cthill/SNESDump/(threads)

Thread 1 (2019-01-16):

Reading stop and program freeze

jeffersonmsb, 2019-01-16:
On my setup, reading stop and program freeze in 32kb or 64kb.
I believe that because my setup is protoboard and my arduino is chinese (USB to serial is CH340).
I reduce the serial baudrate for 115200 and and everything works.

cthill, 2019-01-16:
Hello! I did not have much success with high baud rates on cheap Arduino clones. Try swapping it for an Arduino board with a legitimate FTDI USB to serial chip. I used the Arduino Nano for my build.

Also, what operating system are you using?

jeffersonmsb, 2019-01-17:
Hi. I no have a legitimate arduino and its more expensive in my country.
But that's not a problem for me. Wanted to leave the warning to other people who have cheapest arduino.

I use Debian 9 x64.

Congratulations for the project.

cthill, 2019-01-17:
Ahh I see. Thanks for the info! I will add it to the project documentation. And thanks for trying out the project!

joaopauloap, 2023-06-22:
Oi Jefferson. Meu arduino nano também é com o  CH340. Você conseguiu executar esse projeto? Estou tento problemas, até abri um tópico

jeffersonmsb, 2023-06-23:
Olá, @joaopauloap. Consegui executar sim, em uma protoboard. Deu bastante trabalho porque são muitas conexões pra dar errado. O problema que eu tive foi o de ler e gravar saves, mas ler a ROM correu tudo certo. Qualquer coisa fala aí, valeu.

joaopauloap, 2023-06-23:
Meu principal objetivo é ler rom, ainda não testei o save. Aqui está acontecendo que os bytes estão se repetindo. Em jogos LoRom Quando chega no endereço 7FFF repete tudo desde o endereço 0, Ai quando chega no FFFF repete de novo. e nos HiRom isso acontece a partir do FFFF. Tem alguma ideia do que seja? ja chequei as conexões e parece estar tudo certo.

jeffersonmsb, 2023-06-23:
Pelo padrão que vc relata, me parece ser um mal contato nas conexões do bus de endereço, eu chutaria isso. Acredito pegando esses endereços onde começa a repetição dê pra talvez entender qual conexão seria.

joaopauloap, 2023-06-29:
Oi Jefferson, obrigado. Fiz uma limpeza com alcool isopropilico e uma escova e funcionou, nem precisei resoldar nada (fiz nessas placas furadas universais, pensa no trabalho). Estou pensando aqui se dá pra modificar esse projeto para fazer a escrita nas eproms também, principalmente flash.

jeffersonmsb, 2023-06-30:
Que bom que deu certo. Uma época eu precisei de uma gravadora e daí eu fiz a partir do datasheet do chip que eu queria gravar, mas deve ter algo mais pronto se a gravadora foi o objetivo fim.

Closed 2019-01-17.

Thread 2 (2019-01-24):

Problem reading SRAM

jeffersonmsb, 2019-01-24:
Hello!

A few days ago I'm having trouble trying to read the SRAM of a Super Mario World. I can not get a valid reading.

This cartridge runs normally on the console, recording and reading the SRAM.

I can read cartridges normally without any problem.

I checked the main connections with the multimeter.

I was able to read and write to the SRAM of another cartridge (Yossi Island), but at an address different from what was in the code. I used $ 70: 8000.

The cartridge is a SHVC-1A1M-20 with MAD-1 decoder.

In a last desperation attempt I recorded a SRAM in all banks $ 00 ~ $ FF: 0000 and $ 00 ~ $ FF: 8000 and read again to see if any of the files was what I recorded and none was.

Does anyone have any ideas?

jeffersonmsb, 2023-03-22:
Hi. Yeah, it's been a really long time haha. I miss spending my time on these things..

It was great progress. At the time I would like to save my save. I believe that these delays you put in could have solved my problem.

I don't know how I can help, but I'll be following along.

joaopauloap, 2023-07-08:
I dumped mario world sram with and without save progress and the file generated by the dump is the same in both cases, not working on the emulator. With mario kart it works. Is it because one is LoRom and the other is HiRom or is it something else?

rmarangoni, 2025-01-10:
@joaopauloap atualiza o codigo pra python 3 pra nois ? heheh

jeffbzrr, 2025-01-10:
Eu já usei esse projeto anos atrás.

Você não consegue utilizar uma versão antiga do python?

Em qui., 9 de jan. de 2025 21:32, rmarangoni ***@***.***>
escreveu:

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

rmarangoni, 2025-01-10:
@jeffbzrr cara eu tentei de tudo, instalei o python 2 dai eu não consigo instalar o pip porque fala que não tem mais suporte... dai não roda... tentei instalar python 2 e o 3 instalar o pip no 3 e depois mover pra pasta do 2... nada deu certo.

rmarangoni, 2025-01-10:
@jeffbzrr eu até cheguei a confeccionar uma pcb pra fazer o projeto bonitinho, mas não me liguei no software que tava em python 2 ... tentei lembrar da minha epoca de processamento de dados... mais é muito pra mim hauhauhau

play134, 2025-01-10:
Ola

Também usei esse projeto e roda muito bem, inclusive personalizei em meu fork para dump de x-band.

 Vc tem que instalar a versão 2.7

https://www.python.org/download/releases/2.7/
[https://www.python.org/static/opengraph-icon-200x200.png]<https://www.python.org/download/releases/2.7/>
Python 2.7.0 Release | Python.org<https://www.python.org/download/releases/2.7/>
Python 2.7.0. Note: A bugfix release, 2.7.16, is currently available.Its use is recommended. Python 2.7.0 was released on July 3rd, 2010. Python 2.7 is scheduled to be the last major version in the 2.x series before it moves into an extended maintenance period.
www.python.org

________________________________
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

rmarangoni, 2025-01-10:
@play134 blz até ai eu consigo... mas como eu instalo o pip no python 2.7... tentei de todas as formas e não consigo, dai não consigo instalar os scripts pra rodar.

jeffbzrr, 2025-01-10:
rmaragoni vai dar certo cara. A gente vai te ajudar. Vc usa windows ou
Linux?

Em qui., 9 de jan. de 2025 23:25, rmarangoni ***@***.***>
escreveu:

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

rmarangoni, 2025-01-10:
Uso windows... mas to pensando em instalar linux em um note velho so pra tentar hahaha
eu vou instalar o  2.7.15 que ja tem o pip pra ver se vai

play134, 2025-01-10:
camarada, não entendi muito bem. nao me recordo de usar o pip pra rodar esse projeto.

vc pode instalar uma versão mais nova e usar o pip normalmente.

________________________________
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

rmarangoni, 2025-01-10:
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

jeffbzrr, 2025-01-10:
Você usar um virtualenv do python3 pra usar o 2.7.

Eu nunca usei assim, mas sei que existe essa funcionalidade. Pesquisa sobre
virtualenv

Em qui., 9 de jan. de 2025 23:32, Wallace Carvalho ***@***.***>
escreveu:

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

rmarangoni, 2025-01-10:
Quando uso o 2.7 que não tem o pip instaldo ele nao carrega os imports
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

rmarangoni, 2025-01-10:
Vou instalar linux em um note velho... talvez consiga. no windows impossivel com meus conhecimentos hahaha se bem que não sei nada de linux, mas pelo que li deve ser mais facil

rmarangoni, 2025-01-10:
Muito obrigado pela ajuda @jeffbzrr e @play134  se eu conseguir rodar e a pcb funcionar mando uma pra cada um de vcs tenho 10 aqui

play134, 2025-01-10:
no diretório python27/scripts/ nao tem o pi la ?

tenta isso aqui

https://stackoverflow.com/questions/8491111/pyserial-for-python-2-7-2
***@***.***?v=73d79a89bded]<https://stackoverflow.com/questions/8491111/pyserial-for-python-2-7-2>
pyserial for Python 2.7.2 - Stack Overflow<https://stackoverflow.com/questions/8491111/pyserial-for-python-2-7-2>
As a slight update there is still the problem that python 64bit for Windows is not compatible with the pyserial installer. What is not mentioned in other answers but I found very useful to know is that Python 32 bit installs and works fine on Win7 64bit and that means the pyserial installer also works fine.. Obviously if you need 64bit python this is no use to you, but I suspect most of us do not.
stackoverflow.com
https://stackoverflow.com/questions/54272891/how-to-install-pip-for-python-2-7
***@***.***?v=73d79a89bded]<https://stackoverflow.com/questions/54272891/how-to-install-pip-for-python-2-7>
how to install pip for python 2.7? - Stack Overflow<https://stackoverflow.com/questions/54272891/how-to-install-pip-for-python-2-7>
Stack Overflow for Teams Where developers & technologists share private knowledge with coworkers; Advertising & Talent Reach devs & technologists worldwide about your product, service or employer brand; OverflowAI GenAI features for Teams; OverflowAPI Train & fine-tune LLMs; Labs The future of collective knowledge sharing; About the company Visit the blog
stackoverflow.com

________________________________
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

rmarangoni, 2025-01-10:
@play134
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

rmarangoni, 2025-01-10:
FOI
CONSEGUI

rmarangoni, 2025-01-10:
CARALHOOOOOOOOOOOOOOOOO manda os endereços que eu mando as plaquinhas

rmarangoni, 2025-01-10:
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

rmarangoni, 2025-01-10:
Usei a versão 2.7.15 que tem o pip dai instalei o pyserial e foi caralhooooooooooooo to felizão

rmarangoni, 2025-01-10:
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

play134, 2025-01-10:
que isso cara. prazer em ajudar mesmo.

mas então. o meu eu fiz na mao e tive varios problemas ate detectar erro no diagrama. o cara ajustou lá em 2020.

na foto que vc mandou, nao apareceu o nome do cartucho.... vc tem q revisar os contatos certinho

________________________________
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

rmarangoni, 2025-01-10:
é eu percebi quando tentei fazer um dump e parou no meio do caminho... vou mandar pra pessoa que desenhou a placa pra mim

Pedrinator, 2025-01-14:
I'm working on that in my freetime. I'm uploading my progress in this web. https://www.fisicomolon.com/2024/12/super-nintendo-de-codigo-abierto.html (not too much yet)
I'm reading rom and sram from linux (bash) and from windows (python). I got Super Mario World and Super mario kart works sram in both ways. I can't Mario Paint make it works. Only in bash. I'm working in python. I read the rom in python, I not tried yet the sram in pytohn.
I show you part of the project in this video. https://www.youtube.com/watch?v=xZo2aWcUpBg&ab_channel=FisicoMolon

If I can help, I will try.

Pedrinator, 2025-02-24:
Hi. I almost finished my proyect. I have my dumper working. I can read roms, and read and write sram both in hirom and lorom. Super mario world works like a charm in both ways. And my Pal super mario kart too. I can write a srm from internet to have all the trophys and the 150cc championship unblocked.

But it doesn't work in my japanese copy of Super Mario Kart, I cant either read or write sram. I can dump rom with no problem at all.
The only diference betwen both carts is the chip mad2 in the japan version and the 74LS139 in the pal version. I guess. Should be the code or the hardware diferente to read both carts?

I have problems to with mario paint (it delete sram if I try to read it). With donkey Kong conutry 2: I can't dump rom, it start ok, but at a random point start to read only "00" in every memory address.

Any advice or information?

Thanks.

play134, 2025-02-24:
Hello

I had some read/write problems with the original code. At the time I made some changes how to calculate sram size and included XBAND modem dump/write support code.

try running my fork and see if it works.

https://github.com/play134/SNESDump/blob/master/desktop/XbandDump.py
[https://opengraph.githubassets.com/b30d29c8cfe49c767507b70d128632b9ac820bd97301282d23005ac2262b7a1b/play134/SNESDump]<https://github.com/play134/SNESDump/blob/master/desktop/XbandDump.py>
SNESDump/desktop/XbandDump.py at master · play134/SNESDump<https://github.com/play134/SNESDump/blob/master/desktop/XbandDump.py>
Arduino powered interface for SNES cartridges. Contribute to play134/SNESDump development by creating an account on GitHub.
github.com

________________________________
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

Pedrinator, 2025-02-24:
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

I just need to know how to configure the read, write, cart and reset pins and what bank and address do you use to read sram in Hirom. Because nothing seems to works.
It works read lorom, Hirom ROMs. It works read and write sram lorom. It works write sram Hirom. But It isnt work read sram in Hirom.

Pedrinator, 2025-02-25:
set_ctrl_lines(port, False, True, hirom, True)

            # compute bank and addresses to write to
            if hirom:
                bank = 0x20
                start_addr = 0x6000
            else:
                bank = 0x30
                start_addr = 0x8000
            end_addr = start_addr + sram_size - 1

********************************
I tried bank 0x20 and star addr 0x6000 and the control lines. And not work for me in super mario kart japan. I do more checks with more game, but its very strange.

Pedrinator, 2025-02-27:
All my games works fine, read and write but Super Mario Kart Japan (i cant read/write sram) And donkey kong contry 2 (cant read full rom, only a part). I realized smk use a mad-2 ic and dkc2 use a mad-1. I thinks it makes the cart has a diferent mapping. Any idea?

Pedrinator, 2025-02-27:
I answer myself. It was a voltage problem. Now everything works fine even the mad-x chips.
https://photos.app.goo.gl/YNkSzBSHzAs6thNV7

Thread 3 (2020-06-15):

Bits swapped in title

AshenClarity, 2020-06-15:
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

Hi! so I threw together a cart reader based on the circuit diagram and Im having a problem where some letters are swapped when reading data, Ive been unable to successfully dump a Rom and I'm guessing its related to this problem. Any chance there are any insights as to what might be the cause?

the games in the contained image for reference are Star Fox and Super Fire Pro Wrestling

play134, 2020-07-13:
Hello!

I have exactly the same problem. I double-checked the wires and continue the same way. I think it is something related to the Arduino clone I use. Unfortunately I have nowhere to buy an authentic one. I tried to reduce the baud rate, as indicated, but I don't know if I'm doing it correctly.

I also tested a starfox cartridge and indicated exactly the same problem as the image you posted. I would like some help if it is possible to use these arduinos on windows.

What operating system and shift register are you using? I'm using 74HC595D (smd). Have you made any progress?

play134, 2020-07-16:
**UPDATE**

ok so i found the problem. The diagram is wrong with respect to the firmware. Simply change the wires D0 and D1 and make the dump. I hope it helps.

cthill, 2020-11-03:
@play134 Thank you for the feedback. I have updated the circuit diagram.

Closed 2020-11-03.

Thread 7 (2025-01-08):

Problem to install the software

rmarangoni, 2025-01-08:
Hi guys i use windows and i have this error msg...
Traceback (most recent call last):
  File "C:\snes\snesdump.py", line 288, in <module>
    main()
    ~~~~^^
  File "C:\snes\snesdump.py", line 55, in main
    port_selection = get_port()
  File "C:\snes\snesdump.py", line 50, in get_port
    return int(raw_input("Please select a device: "))
               ^^^^^^^^^
NameError: name 'raw_input' is not defined

cthill, 2025-01-08:
@rmarangoni Hello! This project is quite old and was built using Python 2.7. Based on the error message you shared, it looks like you are running Python 3.x. Try installing Python 2.7.

rmarangoni, 2025-01-08:
Ohhh ok i will do that ... thanks a lot

rmarangoni, 2025-01-08:
=( i install the python 2.7 but i cant install the the pip
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
=( too bad

rmarangoni, 2025-01-08:
i made a board for nothing lol
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

rmarangoni, 2025-01-08:
anyway thx a lot @cthill I should have tested the software before ordering the boards and purchasing the components.

cthill, 2025-01-08:
@rmarangoni Where did you source the cart edge connector for your board? Back when I did this project, I had to salvage them from broken SNES consoles.

rmarangoni, 2025-01-08:
@cthill https://pt.aliexpress.com/item/1005005016059093.html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

rmarangoni, 2025-01-08:
Nes, Snes, GBA, N64... =D

rmarangoni, 2025-01-09:
doesnt not work... but thx anyway... i will ask to someone who know how to do that

rmarangoni, 2025-01-10:
Any good samaritan to upgrade the code to python 3 ?

rmarangoni, 2025-01-10:
@cthill I got man !!! with python 2.7.15 THX A LOT !!! YOU ARE THE MAN
