cthill/SNESDump/(commit log)

2016-01-03 Dumping script no longer opens every serial port
    [snesdump.py]
2016-01-05 Cleanup & bug fixes. 6x speedup using hardware spi
    [firmware.ino, snesdump.py]
2016-10-27 Fixed bug with sram read and write
    [snesdump.py]
2016-10-29 Updated circuit diagram
2016-10-29 Software now detects if cart slot is empty
2020-11-03 Fix circuit.png
